wuyawei0419/PeepHole/README.md

# PeepHole
STM32F0+OV7670+TFT：及其低成本的摄像头显示方案
https://www.bilibili.com/video/BV1HN4y1c7U9/?vd_source=85782f45855774b49508594616c4c1f6
