wuyawei0419/PeepHole/Core/Src/main.c

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
/* Includes ------------------------------------------------------------------*/
#include "main.h"

/* USER CODE BEGIN Includes */
#include "peephole.h"
//#include "ili9486.h"
#include "ili9341.h"
#include "ov7670.h"
#include "button.h"
#include "sccb.h"
/* USER CODE END Includes */


void SystemClock_Config(void);
/**
  * @brief  The application entry point.
  * @retval int
  */
int main(void)
{
  /* MCU Configuration--------------------------------------------------------*/

  /* Reset of all peripherals, Initializes the Flash interface and the Systick. */
  HAL_Init();

  /* Configure the system clock */
  SystemClock_Config();

  /* Initialize all configured peripherals */
  /* USER CODE BEGIN 2 */
	PeepHole_Init();
	ILI9341_Board_Init();
	SCCB_Init();
	Button_Init();
	PeepHole_Sleep();
  /* USER CODE END 2 */

  /* Infinite loop */
  /* USER CODE BEGIN WHILE */
  while (1)
  {
  	PeepHole_Task();
  	Button_Task();
    /* USER CODE END WHILE */

    /* USER CODE BEGIN 3 */
  }
  /* USER CODE END 3 */
}

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
/* USER CODE BEGIN 4 */


/**
  * @brief  EXTI line detection callback.
  * @param  GPIO_Pin Specifies the port pin connected to corresponding EXTI line.
  * @retval None
  */
void HAL_GPIO_EXTI_Callback(uint16_t GPIO_Pin)
{
	if(GPIO_Pin == OV_VSYNC_GPIO_PIN)
	{
		PeepHole_OV_VSYNC_EXTI_Callback();
	}
	else if(GPIO_Pin == BUTTON_USER_GPIO_PIN)
	{
		Button_EXTI_Callback(BUTTON_USER_GPIO_PIN);
	}
	else if(GPIO_Pin == BUTTON_MCU_GPIO_PIN)
	{
		Button_EXTI_Callback(BUTTON_MCU_GPIO_PIN);
	}
}











/* USER CODE END 4 */
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
