wuyawei0419/PeepHole/Core/Src/peephole.c

/**
  ******************************************************************************
  * @file    peephole.c
  * @author  ZhuSL
  * @brief   功能整合：LCD TFT+OV摄像头+N74LVC1G125+N74LVC1G08+N74LVC245
  *
  ******************************************************************************
  */
	
#include "peephole.h"
#include "ili9341.h"
//#include "ili9486.h"
#include "main.h"
#include "ov7670.h"

/*帧中断标志位，摄像头每帧图像数据来临前此变量置位*/
static volatile FlagStatus PEEPHOLE_FRAME_INTERRUPT_FLAG = RESET;
/*心跳计数器*/
volatile uint32_t u32PEEPHOLE_SLEEP_TICK_COUNTER = 0;
/*猫眼运行标志位*/
static FlagStatus PEEPHOLE_RUN_FLAG = RESET;
/*猫眼运行使能，当此标志置位，则执行一次PeepHole_Run并复位*/
static volatile FunctionalState PEEPHOLE_RUN_ENABLE = DISABLE;
/*猫眼睡眠使能，当此标志置位，则执行一次PeepHole_Sleep并复位*/
static volatile FunctionalState PEEPHOLE_SLEEP_ENABLE = DISABLE;


/**
  * @brief  初始化PeepHole GPIO
  * @param  None
  * @retval None
  */
void PeepHole_Init(void)
{
	GPIO_InitTypeDef GPIO_Initure;
	
	SN74LV125_OE_GPIO_CLK_ENABLE();
	SN74LV245_OE_GPIO_CLK_ENABLE();
	OV_VSYNC_GPIO_CLK_ENABLE();
	POWER_GPIO_CLK_ENABLE();
	
	GPIO_Initure.Pin = SN74LV125_OE_GPIO_PIN;				/*pin号*/
	GPIO_Initure.Mode = GPIO_MODE_OUTPUT_PP;		/*推挽输出*/
	GPIO_Initure.Pull = GPIO_NOPULL;						/*无上下拉*/
	GPIO_Initure.Speed = GPIO_SPEED_FREQ_HIGH;	/*高速*/
	HAL_GPIO_Init(SN74LV125_OE_GPIO_PORT, &GPIO_Initure);
	
	GPIO_Initure.Pin = SN74LV245_OE_GPIO_PIN;				/*pin号*/
	GPIO_Initure.Mode = GPIO_MODE_OUTPUT_PP;		/*推挽输出*/
	GPIO_Initure.Pull = GPIO_NOPULL;						/*无上下拉*/
	GPIO_Initure.Speed = GPIO_SPEED_FREQ_HIGH;	/*高速*/
	HAL_GPIO_Init(SN74LV245_OE_GPIO_PORT, &GPIO_Initure);

	GPIO_Initure.Pin = POWER_GPIO_PIN;				/*pin号*/
	GPIO_Initure.Mode = GPIO_MODE_OUTPUT_PP;		/*推挽输出*/
	GPIO_Initure.Pull = GPIO_NOPULL;						/*无上下拉*/
	GPIO_Initure.Speed = GPIO_SPEED_FREQ_HIGH;	/*高速*/
	HAL_GPIO_Init(POWER_GPIO_PORT, &GPIO_Initure);
	
	GPIO_Initure.Pin = OV_VSYNC_GPIO_PIN;				/*pin号*/
	GPIO_Initure.Mode = GPIO_MODE_IT_FALLING;		/*外部中断*/
	GPIO_Initure.Pull = GPIO_PULLUP;						/*上拉*/
	GPIO_Initure.Speed = GPIO_SPEED_FREQ_HIGH;	/*高速*/
	HAL_GPIO_Init(OV_VSYNC_GPIO_PORT, &GPIO_Initure);
	
  HAL_NVIC_SetPriority(OV_VSYNC_GPIO_IRQn, 2, 0);
  HAL_NVIC_EnableIRQ(OV_VSYNC_GPIO_IRQn);

	PeepHole_EXTI_Control(DISABLE);
	PeepHole_OV_2_LCD_Control(DISABLE);
	PeepHole_LCD_WR_Control(DISABLE);
	PeepHole_Power_Control(DISABLE);
}




/**
  * @brief  SN74LVC1G125DBVR 芯片上的OE引脚
  * @param  State:开启或关闭
	*		#ENABLE:使能
	*		#DISABLE:失能
	*	@note		该引脚低电平有效，当低电平时，125芯片的Y输出取决于A，当高电平时，Y为高阻抗断开
  * @retval None
  */
void PeepHole_LCD_WR_Control(FunctionalState State)
{	
	switch(State)
	{
		case ENABLE:
			SN74LV125_OE_GPIO_WRITE(GPIO_PIN_RESET);
			break;
		case DISABLE:
			SN74LV125_OE_GPIO_WRITE(GPIO_PIN_SET);
			break;
		default:
			break;
	}
}


/**
  * @brief  SN74LVC245APWR 芯片上的OE引脚
  * @param  State:开启或关闭
	*		#ENABLE:使能
	*		#DISABLE:失能
	*	@note		该引脚低电平有效，当低电平时，LCD的data数据来源于OV，当高电平时，LCD与OV断开，只与MCU连接
  * @retval None
  */
void PeepHole_OV_2_LCD_Control(FunctionalState State)
{	
	switch(State)
	{
		case ENABLE:
			SN74LV245_OE_GPIO_WRITE(GPIO_PIN_RESET);
			break;
		case DISABLE:
			SN74LV245_OE_GPIO_WRITE(GPIO_PIN_SET);
			break;
		default:
			break;
	}
}


/**
  * @brief  控制摄像头、LCD、三个74芯片的电源
  * @param  State:开启或关闭
	*		#ENABLE:使能
	*		#DISABLE:失能
  * @retval None
  */
void PeepHole_Power_Control(FunctionalState State)
{	
	switch(State)
	{
		case ENABLE:
			POWER_GPIO_WRITE(GPIO_PIN_RESET);
			break;
		case DISABLE:
			POWER_GPIO_WRITE(GPIO_PIN_SET);
			break;
		default:
			break;
	}
}


/**
  * @brief  开启或关闭中断
  * @param  State
	*		#DISABLE
	*		#ENABLE
  * @retval None
  */
void PeepHole_EXTI_Control(FunctionalState State)
{
	static GPIO_InitTypeDef GPIO_Initure = {.Pull = GPIO_PULLUP, .Speed = GPIO_SPEED_FREQ_HIGH, .Pin = OV_VSYNC_GPIO_PIN};
	
	if(State == DISABLE)
	{
		GPIO_Initure.Mode = GPIO_MODE_INPUT;				/*输入*/
	}
	else
	{
		GPIO_Initure.Mode = GPIO_MODE_IT_FALLING;		/*外部中断*/
	}

	HAL_GPIO_Init(OV_VSYNC_GPIO_PORT, &GPIO_Initure);		
}


/**
  * @brief  OV摄像头帧同步信号中断回调
  * @param  None
  * @retval None
  */
void PeepHole_OV_VSYNC_EXTI_Callback(void)
{
	PEEPHOLE_FRAME_INTERRUPT_FLAG = SET;
}



/**
  * @brief  心跳计数
  * @param  None
  * @retval None
  */
void PeepHole_Tick_Callback(void)
{
	if(u32PEEPHOLE_SLEEP_TICK_COUNTER)
	{
		u32PEEPHOLE_SLEEP_TICK_COUNTER--;
		if(!u32PEEPHOLE_SLEEP_TICK_COUNTER)
		{
			PEEPHOLE_SLEEP_ENABLE = ENABLE;
		}
	}
}


/**
  * @brief  获取帧中断标志是否置位
  * @param  None
  * @retval 是否置位
  *		#RESET:未置位
  *		#SET:置位
  */
FlagStatus PeepHole_Get_FrameIntFlag(void)
{
	static FlagStatus temp = RESET;

	temp = PEEPHOLE_FRAME_INTERRUPT_FLAG;

	return temp;
}



/**
  * @brief  复位帧中断标志位
  * @param  None
  * @retval None
  */
void PeepHole_Reset_FrameIntFlag(void)
{
	PEEPHOLE_FRAME_INTERRUPT_FLAG = RESET;
}




/**
  * @brief  获取睡眠标志
  * @param  None
  * @retval SET/RESET
  *		#SET
  *		#RESET
  */
FlagStatus PeepHole_Get_RunFlag(void)
{
	return PEEPHOLE_RUN_FLAG;
}



/**
  * @brief  使能运行标志位
  * @param  None
  * @retval None
  */
void PeepHole_Enable_Run(void)
{
	PEEPHOLE_RUN_ENABLE = ENABLE;
}


/**
  * @brief  使能睡眠标志位
  * @param  None
  * @retval None
  */
void PeepHole_Enable_Sleep(void)
{
	PEEPHOLE_SLEEP_ENABLE = ENABLE;
}


/**
  * @brief  重载睡眠计数器
  * @param  None
  * @retval None
  */
void PeepHole_SleepCounter_Reload(void)
{
	u32PEEPHOLE_SLEEP_TICK_COUNTER = PEEPHOLE_SLEEP_ENTER_TIMEOUT;
}


/**
  * @brief  清楚睡眠计数器，立即进入睡眠
  * @param  None
  * @retval None
  */
void PeepHole_SleepCounter_Clear(void)
{
	u32PEEPHOLE_SLEEP_TICK_COUNTER = 0;
}

/**
  * @brief  打开猫眼
  * @param  None
  * @retval None
  */
void PeepHole_Run(void)
{
	PeepHole_Init();
	PeepHole_Power_Control(ENABLE);

	ILI9341_Board_Init();
	ILI9341_APP_Init();
	ILI9341_ClearScreen(ILI9341_COLOR_WHITE);		
	ILI9341_DataPort_IN();

	OV7670_Init();

	PeepHole_OV_2_LCD_Control(ENABLE);
	PeepHole_LCD_WR_Control(ENABLE);	
	PeepHole_EXTI_Control(ENABLE);			

	PEEPHOLE_RUN_FLAG = SET;
	u32PEEPHOLE_SLEEP_TICK_COUNTER = PEEPHOLE_SLEEP_ENTER_TIMEOUT;
}





/**
  * @brief  peephole sleep
  * @param  None
  * @retval None
  */
void PeepHole_Sleep(void)
{
	GPIO_InitTypeDef  GPIO_InitStruct;

	__HAL_RCC_GPIOA_CLK_ENABLE();
	__HAL_RCC_GPIOB_CLK_ENABLE();
	__HAL_RCC_GPIOF_CLK_ENABLE();

	PeepHole_EXTI_Control(DISABLE);				
	PeepHole_LCD_WR_Control(DISABLE);	
	PeepHole_OV_2_LCD_Control(DISABLE);
	PeepHole_Power_Control(DISABLE);

	GPIO_InitStruct.Mode = GPIO_MODE_INPUT;
	GPIO_InitStruct.Pull = GPIO_PULLDOWN;
	GPIO_InitStruct.Speed = GPIO_SPEED_FREQ_HIGH;
	GPIO_InitStruct.Pin = ~(GPIO_PIN_13 | GPIO_PIN_14);
	HAL_GPIO_Init(GPIOA, &GPIO_InitStruct);

	GPIO_InitStruct.Mode = GPIO_MODE_INPUT;
	GPIO_InitStruct.Pull = GPIO_PULLDOWN;
	GPIO_InitStruct.Speed = GPIO_SPEED_FREQ_HIGH;
	GPIO_InitStruct.Pin = GPIO_PIN_0|GPIO_PIN_1|GPIO_PIN_5|GPIO_PIN_6|GPIO_PIN_7;
	HAL_GPIO_Init(GPIOB, &GPIO_InitStruct);	

	GPIO_InitStruct.Mode = GPIO_MODE_INPUT;
	GPIO_InitStruct.Pull = GPIO_PULLDOWN;
	GPIO_InitStruct.Speed = GPIO_SPEED_FREQ_HIGH;
	GPIO_InitStruct.Pin = GPIO_PIN_0|GPIO_PIN_1;
	HAL_GPIO_Init(GPIOF, &GPIO_InitStruct);		

	PEEPHOLE_RUN_FLAG = RESET;
	u32PEEPHOLE_SLEEP_TICK_COUNTER = 0;

	HAL_PWR_EnterSTOPMode(PWR_LOWPOWERREGULATOR_ON, PWR_STOPENTRY_WFI);
	SystemClock_Config();

	/*防止按键唤醒却没有有效键值输入，则超时睡眠*/
	u32PEEPHOLE_SLEEP_TICK_COUNTER = PEEPHOLE_SLEEP_ENTER_TIMEOUT;
}




/**
  * @brief  猫眼应用主任务，循环调用
  * @param  None
  * @retval None
  */
void PeepHole_Task(void)
{
	if(PeepHole_Get_FrameIntFlag() == SET)
	{
		PeepHole_EXTI_Control(DISABLE);
		
		ILI9341_DataPort_OUT();
		
		PeepHole_LCD_WR_Control(DISABLE);
		PeepHole_OV_2_LCD_Control(DISABLE);
		
		ILI9341_Address_Set(0, 0, ILI9341_HEIGHT-1, ILI9341_WIDTH-1);
		
		ILI9341_RS_WRITE(GPIO_PIN_SET);
		ILI9341_WR_WRITE(GPIO_PIN_RESET);
		
		PeepHole_LCD_WR_Control(ENABLE);
		PeepHole_OV_2_LCD_Control(ENABLE);
		
		ILI9341_DataPort_IN();
		
		PeepHole_EXTI_Control(ENABLE);	

		PeepHole_Reset_FrameIntFlag();
	}
	if(PEEPHOLE_SLEEP_ENABLE == ENABLE)
	{
		PEEPHOLE_SLEEP_ENABLE = DISABLE;
		PeepHole_Sleep();
	}
	if(PEEPHOLE_RUN_ENABLE == ENABLE)
	{
		PEEPHOLE_RUN_ENABLE = DISABLE;
		PeepHole_Run();
	}
}
