wuyawei0419/PeepHole/Core/Inc/powermanager.h

/**
  ******************************************************************************
  * @file    powermanager.h
  * @author  ZhuSL
  * @brief   电源管理
  *
  ******************************************************************************
  * @attention
  *		None
  *
  ******************************************************************************
  */

#ifndef _POWERMANAGER_H_
#define _POWERMANAGER_H_
















#endif
