wuyawei0419/PeepHole/(commit log)

2020-11-02 摄像头不行，屏幕可以驱动
2020-11-03 OV7670 SCCB 通讯OK，(跳线版本)
2020-11-03 在线debug下，OV7670_Init如果单步走的话竟然会失败！
2020-11-05 摄像头的SCCB通讯不行！
2020-11-07 debug version 依旧无法成像
2020-11-07 修改了LCD驱动还是不行...
2020-11-10 能较清晰成像，但还是不正常
2020-11-14 sccb通讯成功！
2020-11-14 虽然摄像头SCCB通讯OK了，但9341/9325屏幕还是那个鸟样
2020-11-23 9486屏幕也是不行
2020-11-23 ILI9341能正常显示摄像头图像了！原因详见注释；顺便增加ILI9486源文件
2020-11-24 删除大量没用到或无必要的代码
2020-11-25 9486增加函数
2020-11-25 9486屏也能正常输出图像了，虽然是QVGA格式
2020-11-25 OV7670增加设置输出窗口函数
2020-11-25 9486还是无法全屏输出
2020-11-26 改回了9341
2020-11-28 修改PeepHole相关代码，更好的封装代码
2020-11-28 ILI9341的HAL操作IO口改为寄存器操作以提高速度，修改其他地方的延时及相关代码以提高成像速度
2020-11-28 修改HAL库函数为寄存器操作以提高速度
2020-11-28 增加按键驱动代码
2020-11-29 修改按键驱动的一处bug
2020-11-29 低功耗正常，10uA
2020-11-29 试图将低功耗功能另外放在一个文件上，现在待定，也许可以放在PeepHole源文件
2020-12-01 较完善地实现了猫眼+按键+超时睡眠的功能
2020-12-04 上电默认进入睡眠
2022-09-07 add schematic.pdf file
